ronakpjain/roco/pcb/power.kicad_sch

## KiCad design pcb/power.kicad_sch (2026-11-13)

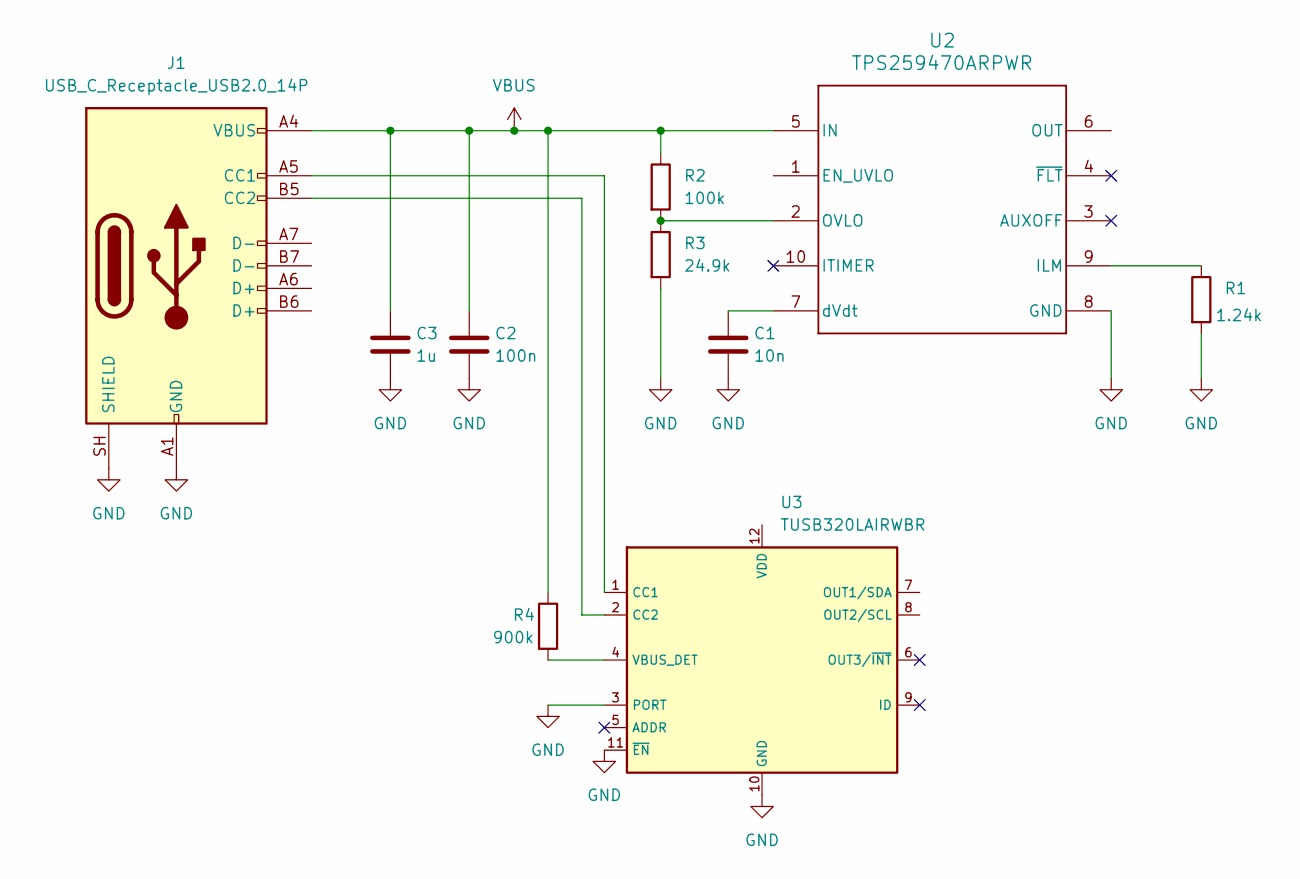
[picture p2: schematic power.kicad_sch]

Parts:
C1: 10n
C2: 100n
C3: 1u
J1: USB_C_Receptacle_USB2.0_14P
R1: 1.24k; R_0603_1608Metric; Tolerance 0.1%
R2: 100k; R_0603_1608Metric; Tolerance 0.1%
R3: 24.9k; R_0603_1608Metric; Tolerance 0.1%
R4: 900k
U2: TPS259470ARPWR; RPW0010A-MFG
U3: TUSB320LAIRWBR; RWB0012A_TEX

Connections:
GND: C1.2, C2.2, C3.2, J1.A1 (GND), J1.A12 (GND), J1.B1 (GND), J1.B12 (GND), J1.SH (SHIELD), R1.2, R3.2, U2.8 (GND), U3.3 (PORT), U3.10 (GND), U3.11 (~EN)
unnamed: C1.1, U2.7 (dVdt)
unnamed: J1.A5 (CC1), U3.1 (CC1)
unnamed: J1.B5 (CC2), U3.2 (CC2)
unnamed: R1.1, U2.9 (ILM)
unnamed: R2.2, R3.1, U2.2 (OVLO)
unnamed: R4.2, U3.4 (VBUS_DET)
VBUS: C2.1, C3.1, J1.A4 (VBUS), J1.A9 (VBUS), J1.B4 (VBUS), J1.B9 (VBUS), R2.1, R4.1, U2.5 (IN)
