ronakpjain/roco/cpu/sw/hello/main.c

// Hello world and cache-counter demo for the roco SoC.

#include "roco_io.h"

static unsigned int crc32(const unsigned char *data, unsigned int length) {
  unsigned int crc = 0xffffffffu;
  for (unsigned int i = 0; i < length; i++) {
    crc ^= data[i];
    for (int bit = 0; bit < 8; bit++) {
      crc = (crc >> 1) ^ (0xedb88320u & (0u - (crc & 1u)));
    }
  }
  return ~crc;
}

int main(void) {
  unsigned int before;
  unsigned int after;
  unsigned int i;
  unsigned int sum = 0;
  volatile unsigned int *array = (volatile unsigned int *)0x10004000u;

  puts("hello, roco\r\n");

  // Fill 4 KiB with a pattern, then sum it repeatedly. The first pass
  // misses in the D-cache; later passes hit.
  for (i = 0; i < 1024; i++) {
    array[i] = i + (i << 8) + 0x5a5a5a5au;
  }
  before = read_mcycle();
  unsigned int inst_before = read_minstret();
  for (i = 0; i < 64; i++) {
    for (unsigned int j = 0; j < 1024; j++) {
      sum += array[j];
    }
  }
  after = read_mcycle();
  unsigned int inst_after = read_minstret();

  *(volatile unsigned int *)0x80000048u = after - before;
  *(volatile unsigned int *)0x8000004cu = inst_after - inst_before;

  puts("sum=");
  for (int shift = 28; shift >= 0; shift -= 4) {
    putc("0123456789abcdef"[(sum >> shift) & 0xf]);
  }
  puts(" cycles=");
  for (int shift = 28; shift >= 0; shift -= 4) {
    putc("0123456789abcdef"[(after - before) >> shift & 0xf]);
  }
  puts(" instret=");
  for (int shift = 28; shift >= 0; shift -= 4) {
    putc("0123456789abcdef"[(inst_after - inst_before) >> shift & 0xf]);
  }
  puts("\r\nicache hits=");
  for (int shift = 28; shift >= 0; shift -= 4) {
    putc("0123456789abcdef"[(ICACHE_HITS >> shift) & 0xf]);
  }
  puts(" misses=");
  for (int shift = 28; shift >= 0; shift -= 4) {
    putc("0123456789abcdef"[(ICACHE_MISSES >> shift) & 0xf]);
  }
  puts("\r\ndcache hits=");
  for (int shift = 28; shift >= 0; shift -= 4) {
    putc("0123456789abcdef"[(DCACHE_HITS >> shift) & 0xf]);
  }
  puts(" misses=");
  for (int shift = 28; shift >= 0; shift -= 4) {
    putc("0123456789abcdef"[(DCACHE_MISSES >> shift) & 0xf]);
  }
  puts("\r\ncrc32=");
  unsigned int crc = crc32((const unsigned char *)0x10000000u, 64);
  for (int shift = 28; shift >= 0; shift -= 4) {
    putc("0123456789abcdef"[(crc >> shift) & 0xf]);
  }
  puts("\r\n");

  LEDS = 0x5;
  return 0;
}
