ronakpjain/roco/cpu/rtl/core/rv32_id_stage.sv

// Instruction decode stage.
//
// Owns the register file and the ID/EX pipeline register. Decode is
// combinational; the register file read port bypasses the writeback
// write in the same cycle. The hazard unit consumes the combinational
// source-register information even while this stage is held.

`default_nettype none
`include "rv32_defs.svh"

module rv32_id_stage (
  input logic clk,
  input logic rst,
  input logic halt,
  input logic if_valid,
  input logic [31:0] if_pc,
  input logic [31:0] if_instr,
  input logic if_fault,
  input logic if_pred_taken,
  input logic [31:0] if_pred_target,
  input logic hold,
  input logic flush,
  input logic bubble,
  input logic exmem_valid,
  input logic exmem_regwrite,
  input logic [4:0] exmem_rd,
  /* Writeback port into the register file. */
  input logic wb_we,
  input logic [4:0] wb_rd,
  input logic [31:0] wb_data,
  /* Combinational decode, for the hazard unit. */
  output logic [4:0] dec_rs1,
  output logic [4:0] dec_rs2,
  output logic dec_use_rs1,
  output logic dec_use_rs2,
  /* ID/EX pipeline register. */
  output logic idex_valid,
  output logic [31:0] idex_pc,
  output logic [31:0] idex_instr,
  output logic idex_ifault,
  output logic idex_pred_taken,
  output logic [31:0] idex_pred_target,
  output logic [31:0] idex_rs1_val,
  output logic [31:0] idex_rs2_val,
  output logic idex_rs1_from_mem,
  output logic idex_rs2_from_mem,
  output logic idex_rs1_from_wb,
  output logic idex_rs2_from_wb,
  output logic idex_rs1_from_rf,
  output logic idex_rs2_from_rf,
  output logic [31:0] idex_imm,
  output logic [4:0] idex_rs1,
  output logic [4:0] idex_rd,
  output logic [2:0] idex_funct3,
  output logic [3:0] idex_alu_op,
  output logic idex_alu_b_imm,
  output logic idex_alu_a_pc,
  output logic idex_regwrite,
  output logic idex_is_load,
  output logic idex_is_store,
  output logic idex_is_branch,
  output logic idex_is_jal,
  output logic idex_is_jalr,
  output logic idex_is_csr,
  output logic idex_csr_uimm,
  output logic [1:0] idex_csr_op,
  output logic [11:0] idex_csr_addr,
  output logic idex_illegal,
  output logic idex_ecall,
  output logic idex_ebreak,
  output logic idex_mret,
  output logic idex_sret,
  output logic idex_is_sfence,
  output logic idex_is_fence_i
);

  logic [31:0] dec_imm;
  logic [2:0] dec_funct3;
  logic dec_alu_b_imm;
  logic dec_alu_a_pc;
  logic [3:0] dec_alu_op;
  logic dec_regwrite;
  logic dec_is_load;
  logic dec_is_store;
  logic dec_is_branch;
  logic dec_is_jal;
  logic dec_is_jalr;
  logic dec_is_csr;
  logic dec_csr_uimm;
  logic [1:0] dec_csr_op;
  logic [11:0] dec_csr_addr;
  logic dec_illegal;
  logic dec_ecall;
  logic dec_ebreak;
  logic dec_mret;
  logic dec_sret;
  logic dec_is_sfence;
  logic dec_is_fence_i;
  logic [4:0] dec_rd;
  logic [31:0] rf_rdata1;
  logic [31:0] rf_rdata2;
  logic ex_can_forward;
  logic mem_can_forward;
  logic rs1_from_mem;
  logic rs2_from_mem;
  logic rs1_matches_wb;
  logic rs2_matches_wb;

  // Compare register numbers one stage early. The instructions now in EX
  // and MEM will be in MEM and WB when the decoded instruction executes.
  // A trap in EX flushes that instruction.
  assign ex_can_forward = idex_valid && idex_regwrite && !idex_is_load && (idex_rd != 5'd0);
  assign mem_can_forward = exmem_valid && exmem_regwrite && (exmem_rd != 5'd0);
  assign rs1_from_mem = ex_can_forward && (dec_rs1 == idex_rd);
  assign rs2_from_mem = ex_can_forward && (dec_rs2 == idex_rd);
  assign rs1_matches_wb = mem_can_forward && (dec_rs1 == exmem_rd);
  assign rs2_matches_wb = mem_can_forward && (dec_rs2 == exmem_rd);

  rv32_decoder u_decoder (
      .instr(if_instr),
      .rs1(dec_rs1),
      .rs2(dec_rs2),
      .rd(dec_rd),
      .funct3(dec_funct3),
      .imm(dec_imm),
      .use_rs1(dec_use_rs1),
      .use_rs2(dec_use_rs2),
      .alu_b_imm(dec_alu_b_imm),
      .alu_a_pc(dec_alu_a_pc),
      .alu_op(dec_alu_op),
      .regwrite(dec_regwrite),
      .is_load(dec_is_load),
      .is_store(dec_is_store),
      .is_branch(dec_is_branch),
      .is_jal(dec_is_jal),
      .is_jalr(dec_is_jalr),
      .is_csr(dec_is_csr),
      .csr_uimm(dec_csr_uimm),
      .csr_op(dec_csr_op),
      .csr_addr(dec_csr_addr),
      .illegal(dec_illegal),
      .ecall(dec_ecall),
      .ebreak(dec_ebreak),
      .mret(dec_mret),
      .sret(dec_sret),
      .is_sfence(dec_is_sfence),
      .is_fence_i(dec_is_fence_i)
  );

  rv32_regfile u_regfile (
      .clk(clk),
      .rst(rst),
      .rs1(dec_rs1),
      .rs2(dec_rs2),
      .we(wb_we),
      .rd(wb_rd),
      .wdata(wb_data),
      .rdata1(rf_rdata1),
      .rdata2(rf_rdata2)
  );

  always_ff @(posedge clk) begin
    if (rst) begin
      idex_valid <= 1'b0;
      idex_pc <= '0;
      idex_instr <= 32'h0000_0013;
      idex_ifault <= 1'b0;
      idex_pred_taken <= 1'b0;
      idex_pred_target <= '0;
      idex_rs1_val <= '0;
      idex_rs2_val <= '0;
      idex_rs1_from_mem <= 1'b0;
      idex_rs2_from_mem <= 1'b0;
      idex_rs1_from_wb <= 1'b0;
      idex_rs2_from_wb <= 1'b0;
      idex_rs1_from_rf <= 1'b1;
      idex_rs2_from_rf <= 1'b1;
      idex_imm <= '0;
      idex_rs1 <= '0;
      idex_rd <= '0;
      idex_funct3 <= '0;
      idex_alu_op <= `RV32_ALU_ADD;
      idex_alu_b_imm <= 1'b0;
      idex_alu_a_pc <= 1'b0;
      idex_regwrite <= 1'b0;
      idex_is_load <= 1'b0;
      idex_is_store <= 1'b0;
      idex_is_branch <= 1'b0;
      idex_is_jal <= 1'b0;
      idex_is_jalr <= 1'b0;
      idex_is_csr <= 1'b0;
      idex_csr_uimm <= 1'b0;
      idex_csr_op <= `RV32_CSR_RW;
      idex_csr_addr <= '0;
      idex_illegal <= 1'b0;
      idex_ecall <= 1'b0;
      idex_ebreak <= 1'b0;
      idex_mret <= 1'b0;
      idex_sret <= 1'b0;
      idex_is_sfence <= 1'b0;
      idex_is_fence_i <= 1'b0;
    end else if (halt || hold) begin
      // Frozen while MEM owns the bus.
    end else begin
      // Only the valid bit needs the flush and bubble controls. Updating
      // the invalid payload keeps those controls off the register enables.
      idex_valid <= if_valid && !flush && !bubble;
      idex_pc <= if_pc;
      idex_instr <= if_instr;
      idex_ifault <= if_fault;
      idex_pred_taken <= if_pred_taken;
      idex_pred_target <= if_pred_target;
      idex_rs1_val <= rf_rdata1;
      idex_rs2_val <= rf_rdata2;
      idex_rs1_from_mem <= rs1_from_mem;
      idex_rs2_from_mem <= rs2_from_mem;
      idex_rs1_from_wb <= !rs1_from_mem && rs1_matches_wb;
      idex_rs2_from_wb <= !rs2_from_mem && rs2_matches_wb;
      idex_rs1_from_rf <= !rs1_from_mem && !rs1_matches_wb;
      idex_rs2_from_rf <= !rs2_from_mem && !rs2_matches_wb;
      idex_imm <= dec_imm;
      idex_rs1 <= dec_rs1;
      idex_rd <= dec_rd;
      idex_funct3 <= dec_funct3;
      idex_alu_op <= dec_alu_op;
      idex_alu_b_imm <= dec_alu_b_imm;
      idex_alu_a_pc <= dec_alu_a_pc;
      idex_regwrite <= dec_regwrite;
      idex_is_load <= dec_is_load;
      idex_is_store <= dec_is_store;
      idex_is_branch <= dec_is_branch;
      idex_is_jal <= dec_is_jal;
      idex_is_jalr <= dec_is_jalr;
      idex_is_csr <= dec_is_csr;
      idex_csr_uimm <= dec_csr_uimm;
      idex_csr_op <= dec_csr_op;
      idex_csr_addr <= dec_csr_addr;
      idex_illegal <= dec_illegal;
      idex_ecall <= dec_ecall;
      idex_ebreak <= dec_ebreak;
      idex_mret <= dec_mret;
      idex_sret <= dec_sret;
      idex_is_sfence <= dec_is_sfence;
      idex_is_fence_i <= dec_is_fence_i;
    end
  end

endmodule
