ronakpjain/roco/(commit log)

2026-11-10 chore(project): initialize KiCad project and schematic hierarchy
2026-11-10 feat(power): add rail allocations and input budget calculator
2026-11-10 docs(design): define Rev A architecture and USB-C PD power interface
2026-11-10 refactor: organize hardware under pcb and document repository layout
2026-11-10 feat(cpu): add instruction decoder and fetch/decode stages
2026-11-10 feat(cpu): add execute, memory, and writeback stages
2026-11-10 feat(cpu): wire the five-stage pipeline together
2026-11-10 feat(cpu): add UART and SDRAM image bootloader
2026-11-10 test(cpu): add boot-over-UART testbench
2026-11-10 feat(cpu): add ECP5 board top with PLL and reset synchronizer
2026-11-10 build(cpu): add ECP5 pin constraints and synthesis targets
2026-11-10 fix(cpu): exclude the board top from simulation builds
2026-11-10 fix(cpu): leave the UART to the application after boot
2026-11-10 fix(cpu): prevent UART transmit overflow and stale bypass data
2026-11-10 fix(cpu): connect load forwarding and restore UART FIFO readiness
2026-11-10 perf(cpu): interlock load uses to cut the MEM-to-EX timing path
2026-11-10 perf(cpu): decouple queued instruction fetch from backend stalls
2026-11-10 fix(cpu): match board data-cache geometry to the verified SoC configuration
2026-11-13 docs(pcb): select raw USB PD input TVS and add manufacturer datasheet
2026-11-13 docs(pcb): simplify parts and power documentation for 5V USB operation
2026-11-13 feat(pcb): add power components and update schematic libraries
